dalcarter90/3d_printing/legion_go2_dual_screen/source/legion_go2_protective_case/Legion Model REV4 PETG.stl

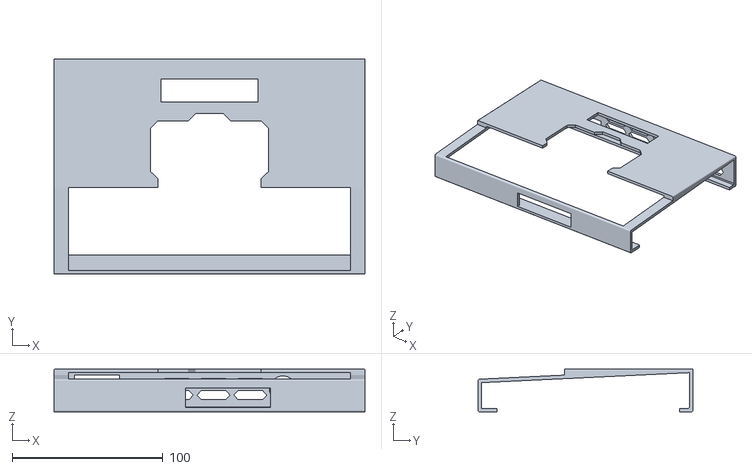
[picture p3: CAD file, 2026-10-01]
legion_go2_dual_screen/source/legion_go2_protective_case/Legion Model REV4 PETG.stl
206.0 x 142.4 x 28.4
