dalcarter90/3d_printing/legion_go2_dual_screen/source/thingiverse_7291595/Legion_Go_Monitor_Holder.stl

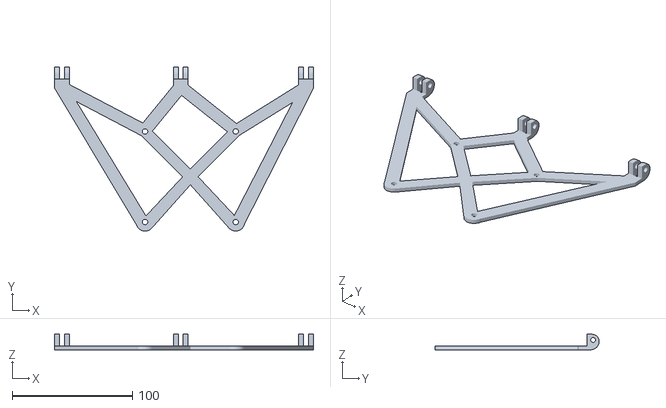
[picture p4: CAD file, 2026-10-01]
legion_go2_dual_screen/source/thingiverse_7291595/Legion_Go_Monitor_Holder.stl
215.2 x 136.5 x 13.0
