dalcarter90/3d_printing/legion_go2_dual_screen/stl/Legion_Go_2_Monitor_Holder.stl

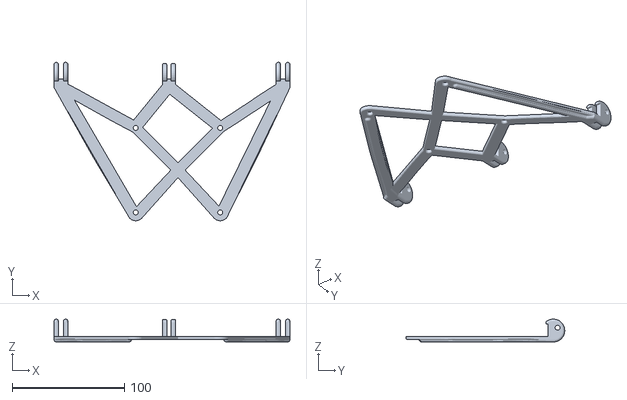
[picture p5: CAD file, 2026-10-01]
legion_go2_dual_screen/stl/Legion_Go_2_Monitor_Holder.stl
210.4 x 141.4 x 20.4
