dalcarter90/3d_printing/legion_go2_dual_screen/source/thingiverse_7291595/Legion_GO_protective_case_-_REV_2.stl

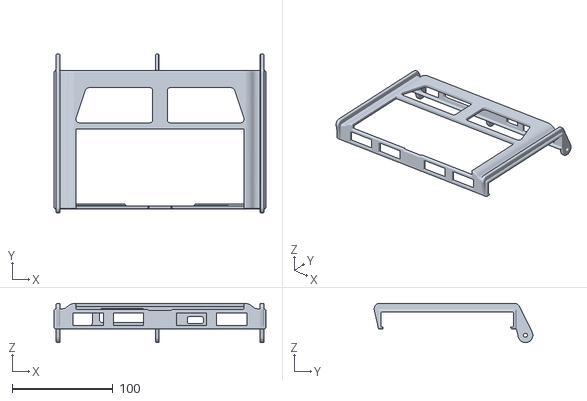
[picture p6: CAD file, 2026-10-01]
legion_go2_dual_screen/source/thingiverse_7291595/Legion_GO_protective_case_-_REV_2.stl
210.8 x 157.9 x 39.0
