dalcarter90/3d_printing/legion_go2_dual_screen/stl/Legion_Go_2_Case_with_Hinge.stl

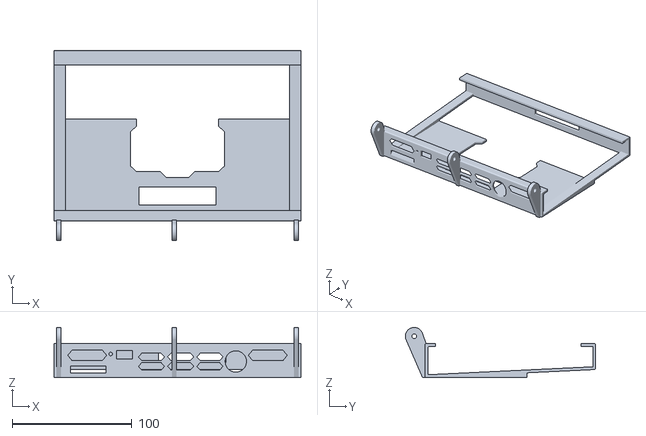
[picture p7: CAD file, 2026-10-01]
legion_go2_dual_screen/stl/Legion_Go_2_Case_with_Hinge.stl
206.0 x 158.7 x 41.8
