dalcarter90/3d_printing/legion_go2_dual_screen/source/thingiverse_7291595/Legion_Go_Monitor_Holder_-_REV_2.stl

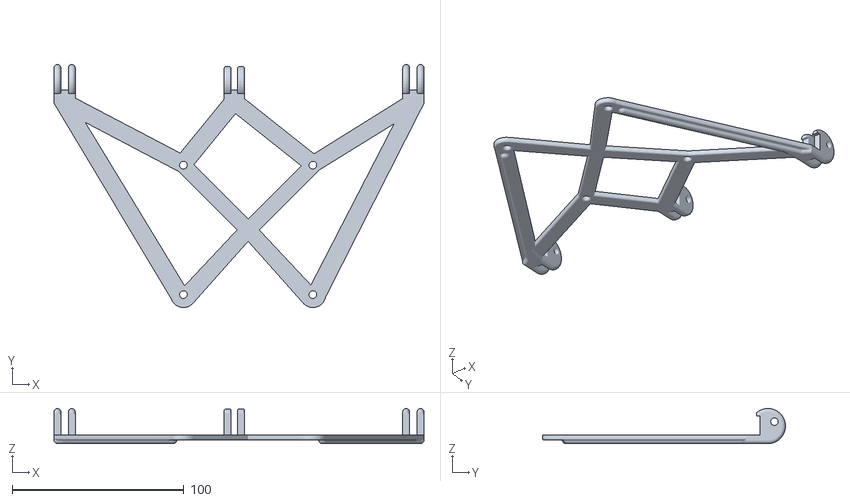
[picture p8: CAD file, 2026-10-01]
legion_go2_dual_screen/source/thingiverse_7291595/Legion_Go_Monitor_Holder_-_REV_2.stl
215.2 x 141.4 x 20.4
