dalcarter90/3d_printing/legion_go2_dual_screen/source/thingiverse_7291595/Legion_Go_Protective_Case_Body.stl

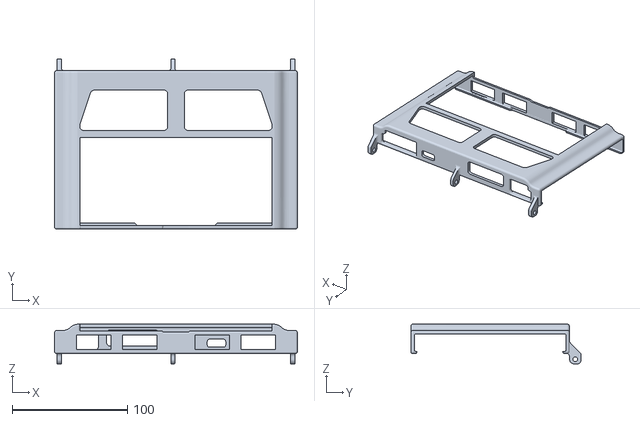
[picture p9: CAD file, 2026-10-01]
legion_go2_dual_screen/source/thingiverse_7291595/Legion_Go_Protective_Case_Body.stl
210.8 x 147.5 x 34.5
