dalcarter90/3d_printing/legion_go2_dual_screen/images/assembly_closed.png

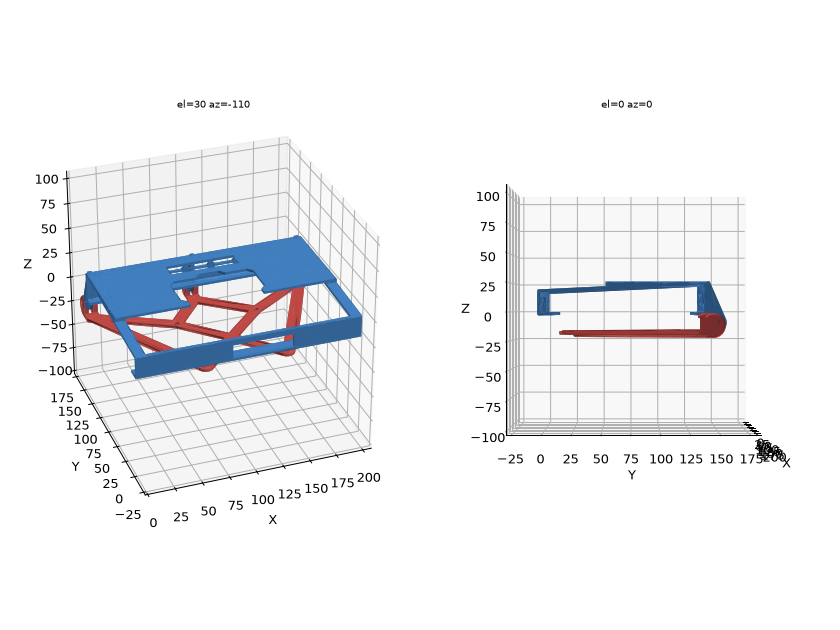
legion_go2_dual_screen/images/assembly_closed.png
