dalcarter90/3d_printing/(commit log)

2026-10-01 Add Legion Go 2 remix of the Legion Go Dual Screen mount
    Remix of davolesh's Thingiverse thing:7291595 (CC BY-SA 4.0) for the
    Legion Go 2: the hinge tabs are rebuilt on a Legion Go 2 protective case
    with the pivot at the same offset from the case's top-front corner, and
    the monitor holder's outer knuckles are moved 2.42 mm inward to match the
    narrower tablet. build.py regenerates both STLs from the source files.
    Claude-Session: https://claude.ai/code/session_01YFnU3tWAzNo4pZaZF8B21M
    [Legion Model REV4 PETG.stl, Legion_GO_protective_case_-_REV_2.stl, Legion_Go_2_Case_with_Hinge.stl, Legion_Go_2_Monitor_Holder.stl, Legion_Go_Monitor_Holder.stl, Legion_Go_Monitor_Holder_-_REV_2.stl, Legion_Go_Protective_Case_Body.stl]
2026-10-01 Export STLs in print orientation and document print times
    Library print services print files as uploaded, so the case is now
    exported back-plate down (tabs up) and both parts sit at the origin.
    README lists MK3S+ slicer estimates for each part.
    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
    [Legion_Go_2_Case_with_Hinge.stl, Legion_Go_2_Monitor_Holder.stl]
